carlbuu/RoboCup_Servo_Humanoid/assets/images/robot-full-view.jpg

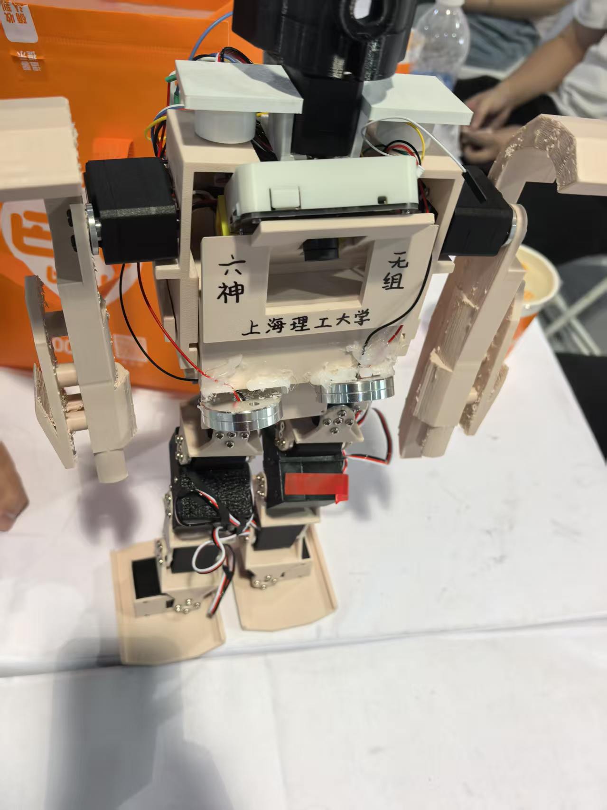
assets/images/robot-full-view.jpg
