carlbuu/RoboCup_Servo_Humanoid/实物图片/robot-front-detail.jpg

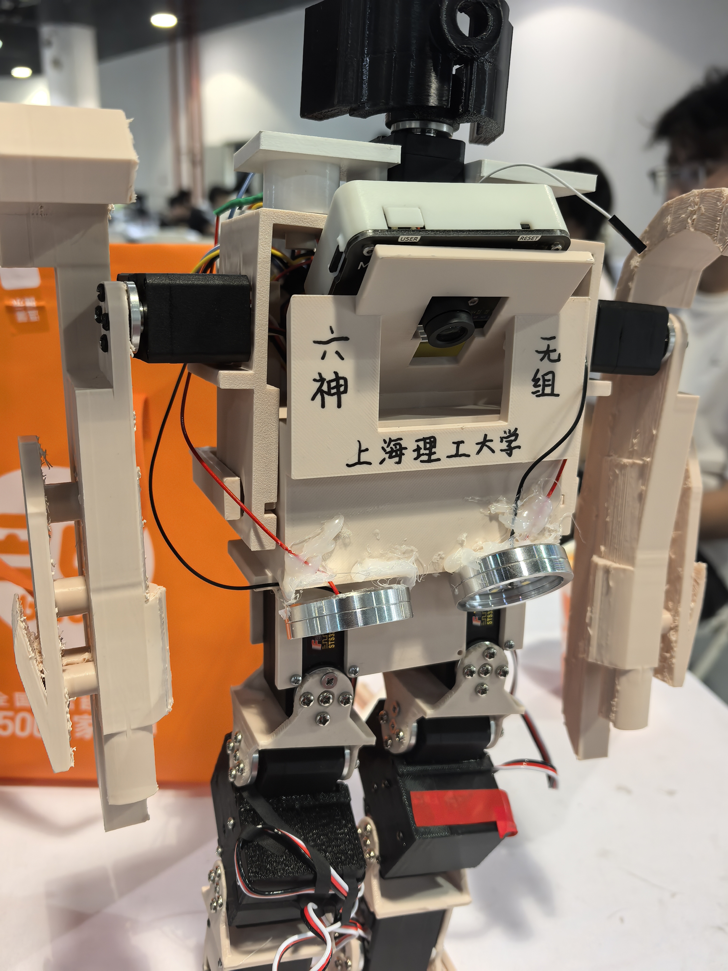
实物图片/robot-front-detail.jpg
