carlbuu/RoboCup_Servo_Humanoid/控制代码.md

---

## 我的电控方案与控制总结

本项目的电控采用“MaixCAM Pro 负责视觉感知、STM32F407 负责动作决策、总线舵机负责关节执行”的分工方式。通过预设动作表和实机步态调试来完成行走、转向及图形动作，并利用视觉结果修正机器人的运动方向。

### 1. 硬件与通信架构

| 模块 | 配置 | 作用 |
|---|---|---|
| 主控制器 | STM32F407，内部 HSI 经 PLL 得到 168 MHz | 解析视觉消息，运行状态机，生成关节目标 |
| 视觉模块 | MaixCAM Pro，`geometry_vision19.py` | 检测赛道边界、判断偏差、识别六种图形 |
| 执行机构 | 13 个 STS3215 总线舵机 | 双腿各 5 个、双臂各 1 个、头部 1 个 |
| 舵机总线 | USART3，经总线转换板连接舵机，1 Mbps | 同步发送各关节的位置、速度和加速度参数 |
| 调试接口 | UART4，PC10 输出，115200 波特率 | 查看动作阶段、视觉接收和通信统计 |

视觉通信使用 USART2，波特率为 115200：相机 TX 接 STM32 的 PD6，相机 RX 接 PA2，各模块共地。相机发送的是前进、转向、平移、停止及图形建议，具体何时执行由 STM32 决定。

整体控制链路为：

```text
图像采集与识别
    → 相机串口发送建议
    → STM32 接收、解析和确认
    → 状态机选择动作及执行时机
    → 动作播放器生成 13 个关节目标
    → 舵机总线同步发送
    → 舵机执行
```

### 2. FreeRTOS 任务分工

控制程序采用 FreeRTOS，将视觉接收、机器人动作调度、舵机发送和调试输出等工作分开处理。视觉接收任务优先处理新数据，机器人任务负责推进动作，舵机任务负责总线发送，低优先级调试任务输出状态。

串口接收采用循环 DMA、空闲中断和消息队列。中断主要负责搬运数据并通知任务，协议解析放在任务中完成，避免在中断里执行较多计算。消息队列保存数据副本，减少接收缓冲区被后续数据覆盖的问题。

我采用这种划分，是为了让接收、决策和执行能够相互配合，减少把串口通信与整段动作混在一起造成的时序问题。FreeRTOS 提供了任务组织方式，通信恢复、请求优先级和动作切换仍需要在程序中明确处理。

### 3. 动作表与关节控制

行走、收脚、左右转向、平移及图形动作都由关键帧动作表描述。每帧保存持续时间和 13 个关节目标角度，角度单位为 0.1°，例如表中的 `180` 对应 18°。

机器人控制任务每 20 ms 推进一次动作，即目标更新频率为 50 Hz。播放器在当前角度与关键帧目标之间做线性插值，让多个关节按统一时间进度运动，而不是直接跳到下一组目标。

```text
当前角度 = 起始角度 +（目标角度 − 起始角度）× 当前帧进度
```

插值后的角度经过舵机 ID 映射，再结合各舵机的中位、方向和软件限位，转换为舵机位置。动作数组下标与 ID 的关系为：

```text
数组下标：0  1  2  3  4  5  6  7  8  9  10 11 12
舵机 ID：5  4  3  2  1  6  7  8  9  10 11 12 13
```

软件发送时，将多个舵机目标装入同一个同步写数据包，通过 USART3 DMA 发送。目标队列长度为 1，新目标可以覆盖尚未取走的旧目标，避免排队执行过期姿态。目标成功进入发送队列，表示软件提交成功，不代表舵机已经实际到位。

当前普通动作速度参数为 1200，快速直行使用 2000；站立和举臂动作使用各自的专用参数。这些数值属于舵机协议参数，不能直接解释为关节的度每秒。

### 4. 视觉巡线与动作调度

视觉程序通过远、近两条扫描带检测赛道中心，远带主要判断前方偏差，近带辅助估计赛道宽度和方向。当前图像分辨率为 640×480，进入纠偏门限为 120 像素，回正门限为 70 像素；使用不同门限，是为了减少前进与纠偏之间的反复切换。

STM32 不会收到一条转向消息就立即打断当前姿态，而是在指定步态窗口内收集新结果，经过两条独立新结果连续同向确认，再决定续走、收脚或纠偏。停止请求独立保存，图形事件单独排队，普通前进建议不能覆盖停止请求。

当前普通采样窗口为动作数组下标 10～11，右转提前采样窗口为下标 9～10。慢速阶段满足姿态匹配、确认和优先级条件时，可以衔接转弯；条件不满足时采用收脚后执行纠偏的路径。快速阶段的转向采用收脚后完整转弯。

协议中的 `TURNL,3`、`TURNR,3` 只提供转向建议，STM32 不按参数 3 换算精确角度或重复次数。实际转角由动作表、脚底接触和机械状态共同决定。

### 5. 慢速与快速步态切换

当前采用两阶段步态：先慢速行走，累计到 30 个软件单脚完成事件后登记切快请求，再完成必要的支撑转换和优先动作，在满足站立条件后切换到快速步态。

30 步是申请切换的阈值，不保证恰好在第 30 步立即换表；为完成支撑转换，实际累计可能达到 31 步。这些计数来自动作帧的软件完成事件，不是脚底传感器确认的落地次数。

快速步态有独立的角度与时长表，配合独立速度参数使用。普通暂停、图形动作和转向不会直接清零累计步数，复位或符合条件的新运行入口可以清零。

### 6. 图形识别与指定动作

视觉侧对图形结果做滑动窗口投票：最近 5 次结果中，同类至少出现 2 票并严格领先其他类别，才触发上报。该投票与 STM32 端巡线的两条同向确认属于不同机制。

| 图形 | 动作 |
|---|---|
| 圆形 | 举左臂 |
| 五角星 | 举右臂 |
| 正方形 | 抬左腿 |
| 菱形 | 抬右腿 |
| 十字形 | 举双臂 |
| 三角形 | 摇头 |

STM32 收到图形事件后，在合适的动作边界结束当前行走、收脚并执行指定动作。当前关闭图形动作前额外完整直行周期，避免无意多走一段距离。视觉侧启用了每类图形在本次程序运行中只触发一次上报尝试的限制，减少重复触发。

### 7. 我的调试认识与当前实现范围

这套方案的重点，是把“视觉建议、动作决策、关节轨迹和总线发送”分开处理。调试时需要分别确认相机是否生成消息、STM32 是否正确接收、状态机是否启动动作，以及机械是否按目标运动，不能仅根据相机打印或编译成功判断整机已经完成动作。

目前行走主要依靠预设步态和视觉方向修正，稳定性很大程度上取决于舵机中位、机械限位、连接件虚位、脚底摩擦和关键帧之间的重心转移。步态调试需要在保护支撑下逐项确认，再逐步增加速度和连续运行距离。
