carlbuu/RoboCup_Servo_Humanoid/比赛资料整理说明.md

# 2026 年 10 月人形机器人比赛资料整理说明

整理日期：2026-10-24。范围仅为原“汇总”文件夹。本文件为整理后的统一阅读入口，参数按本文件夹内的源码核对；它不代表已确认机器人当前烧录的固件或相机正在运行的脚本。

## 1. 资料目录与入口

```text
汇总/
├─ 比赛资料整理说明.md
├─ 01_控制代码/
│  └─ HumanoidRobot_HSI/
│     ├─ MDK-ARM/                 Keil 工程与现有固件
│     ├─ Core/                    初始化、时钟、引脚、任务
│     ├─ User/motion/             动作表、播放器、巡线调度
│     ├─ User/servo/              舵机总线、标定与限位
│     ├─ Drivers/                相机、IMU、串口及芯片驱动
│     ├─ Middlewares/            FreeRTOS 等中间件
│     ├─ Tests/                  测试源码、脚本、桩与必要输入
│     ├─ HumanoidRobot_HSI.ioc    CubeMX 配置
│     └─ 编译.ps1                Keil 批处理编译入口
├─ 02_视觉代码/
│  └─ geometry_vision19.py
├─ 03_机械资料/
│  ├─ 机身/身体.STEP
│  ├─ 手臂/手臂固定1(2).SLDPRT
│  ├─ 头部/头部(1).3mf
│  └─ 腿部/                    5 个 STEP 零件
└─ 04_舵机上位机/
   └─ FD1985-250729/            FD.exe 与配套文件
```

|---|---|
| 打开 STM32 工程 | `01_控制代码/HumanoidRobot_HSI/MDK-ARM/HumanoidRobot_HSI.uvprojx` |
| 查看现有 HEX / AXF | `01_控制代码/HumanoidRobot_HSI/MDK-ARM/HumanoidRobot_HSI/` |
| 运行视觉程序 | `02_视觉代码/geometry_vision19.py`，在 MaixVision / MaixCAM 环境中使用 |
| 改运行模式和步态策略 | `01_控制代码/HumanoidRobot_HSI/User/motion/robot_walk_config.h` |
| 查看动作关键帧 | `01_控制代码/HumanoidRobot_HSI/User/motion/motion_groups.c` |
| 查看关节与舵机 ID 映射 | `01_控制代码/HumanoidRobot_HSI/User/motion/robot_joints.h` |
| 查看中位、方向、限位 | `01_控制代码/HumanoidRobot_HSI/User/servo/servo_manager.c` |
| 打开舵机上位机 | `04_舵机上位机/FD1985-250729/FD.exe` |

## 2. STM32 工程现状

Keil 工程设备字段为 STM32F407VETx，使用 ARM Compiler 5（工程配置 `uAC6=0`）。系统采用内部 HSI，经 PLL 得到 168 MHz；HAL 时基为 TIM6，任务使用 FreeRTOS。具体配置以 `Core/Src/main.c`、`Core/Src/usart.c` 和 `.ioc` 为准。

| 配置项 | 当前值 | 含义 |
|---|---|---|
| `ROBOT_RUN_MODE` | `ROBOT_MODE_FULL_RUN`，3 | 完整巡线与图形动作流程 |
| `ROBOT_DEBUG_MOTION` | `motion_walk_forward` | 只在模式 1 中生效 |
| `ROBOT_CONTROL_PERIOD_MS` | 20 ms | 控制周期 |
| `SERVO_TASK_PERIOD_MS` | 20 ms | 舵机任务周期 |
| `SERVO_ACTIVE_COUNT` / `SERVO_COUNT` | 13 / 13 | 使用 ID1～13 |
| `CAMERA_PROTOCOL_BINARY` | 0 | ASCII 串口协议 |
| `ROBOT_STM_AUTOSTART` | 0 | 等待视觉授权起步 |
| `ROBOT_STM_WALK_BATCH_STEPS` | 4 | 正常批次步数配置 |
| `ROBOT_WALK_LATE_VISION` | 1 | 行走周期后段采样 |
| `ROBOT_WALK_DECIDE_EACH_CYCLE` | 1 | 每周期独立决策 |
| `ROBOT_WALK_VOTE_WINDOW` / `NEED` | 2 / 2 | 两条独立新结果连续同向确认 |
| `ROBOT_WALK_TURN_HANDOFF_ENABLE` | 1 | 启用满足条件时的慢速行走转弯衔接 |
| `ROBOT_SLOW_STAGE_STEPS` | 30 | 到阈值后申请安全切快 |
| `ROBOT_SHAPE_STEP_BEFORE_ACTION` | 0 | 图形动作前不额外增加完整直行周期 |
| `ROBOT_WALK_SETTLE_MS` / `TURN_SETTLE_MS` | 0 / 0 | 组外额外等待为零，动作组内回站时间仍存在 |
| `ROBOT_RX_DIAGNOSTICS_ENABLE` | 0 | 日常关闭详细接收诊断 |

四种模式：1 为动作调试；2 为图形调试；3 为完整流程；4 为巡线调试并忽略图形。模式入口集中在 `robot_walk_config.h`。

### 行走与纠偏

普通采样窗口为数组下标 10～11；右转提前采样窗口为下标 9～10。下标从 0 开始。慢速满足确认、优先级与姿态条件时可衔接转向；未及时满足时仍有原收脚路径。左转接近段含额外一次右脚迈出。停止和图形事件的调度仍由 `robot_walk_vision.c` 处理。

TURN 建议只提供方向，参数不换算成重复转弯次数。一次建议经过 STM32 端确认和调度后执行有限动作，结束后再判断新建议。相机打印发送消息、STM32 接收消息和机器人启动动作是三个不同环节，应分别查看日志。

累计到 30 个软件单脚完成事件后登记切快请求，在安全站立边界切换；可能因支撑转换累计到 31 步。它不是足底落地反馈。快速直行速度参数为 2000，普通动作速度参数为 1200；播放器另有站立和手臂专用分支。快速阶段的转向走收脚后完整转弯路径。复位或成功执行显式新运行入口可清零计步，普通暂停、图形与转弯不会直接清零。

### 编译入口

可在 Keil 打开上述 `.uvprojx`，也可进入 `01_控制代码/HumanoidRobot_HSI/` 后执行：

```powershell
.\编译.ps1
# Keil 安装位置不同时：
.\编译.ps1 -KeilExe '实际安装目录\UV4.exe'
```

脚本通过 `-KeilExe` 参数、`KEIL_UV4` 环境变量或 PATH 中的 `UV4.exe` 定位 Keil，通过临时目录编译后回写生成物；脚本不执行硬件下载。建议使用 PowerShell 7。本次整理没有重新构建。需要下载时先重新编译并核对目标工程与生成物。

## 3. 接线与通信

| 功能 | STM32 引脚 | 接线与速率 |
|---|---|---|
| 调试日志 | PC10，UART4 TX | 接 USB-TTL RXD，115200，8N1；UART4 仅 TX |
| IMU | PA9 TX / PA10 RX，USART1 | 115200，8N1 |
| 相机 | PA2 TX / PD6 RX，USART2 | PA2 接相机 RX、PD6 接相机 TX，115200，8N1 |
| 舵机总线 | PB10 TX / PB11 RX，USART3 | 1 Mbps，经实际使用的总线转换板连接 |
| 固定 GPIO | PA1 | 初始化后输出高电平 |

各模块共地。PA3 在这份 HSI 工程中未用作相机 RX。PC10 是此工程的日志口。

常见日志：`[BOOT] HumanoidRobot_HSI PA1=HIGH DEBUG=PC10`、`[CLOCK] HSI->PLL ...`、`[TURN]`、`[HANDOFF]`、`[GAIT]`、`[STEP]`。结合动作启动与完成日志判断执行情况。

默认 ASCII 示例，每条以换行结束：

```text
CMD,FWD,2
CMD,TURNL,3
CMD,TURNR,3
CMD,HOLD,0
CMD,BLOCKED,0
SHAPE,CIRCLE,1
```

代码还支持左右平移建议。改二进制协议时需同步 STM32 的 `CAMERA_PROTOCOL_BINARY` 与视觉的 `SERIAL_MODE`。视觉脚本中的图形帧为 `AA 55 ID (ID xor A5) 0A`；命令帧为 `AA 57 CMD ARG (CMD xor ARG) 0A`。

| 图形 ID | 图形 | STM32 动作映射 |
|---:|---|---|
| 1 | 圆形 | 左臂 |
| 2 | 五角星 | 右臂 |
| 3 | 正方形 | 左腿 |
| 4 | 菱形 | 右腿 |
| 5 | 十字形 | 双臂 |
| 6 | 三角形 | 摇头 |

动作映射依据 `motion_groups.c` 中的 `MotionGroups_FromQr()`；脚本类别名与 ID 依据 `geometry_vision19.py`。

## 4. 视觉程序

本资料包的视觉入口为 `02_视觉代码/geometry_vision19.py`。该文件用于 MaixCAM / MaixPy v4，可在 MaixVision 中运行。文件名和头部版本注释不能证明设备当前正在运行这一版。

| 参数 | 当前值 | 说明 |
|---|---|---|
| `UART_PORT` / `UART_BAUD` | `/dev/ttyS0` / 115200 | 当前配置会尝试打开 UART；文件内“仅调视觉”注释不等于禁止发送 |
| `SERIAL_MODE` | `ascii` | 对应 STM32 默认协议 |
| `CORR_ON` | `True` | 允许纠偏建议 |
| `CORR_E_TOL` / `CORR_E_OK` | 120 / 70 | 偏差与回正门限，按脚本分辨率缩放逻辑使用 |
| `CORR_BAND` / `CORR_BAND_N` | 0.62 / 0.90 | 远、近扫描带比例 |
| `CORR_SEND_INTERVAL_MS` | 100 ms | 建议发送间隔限制，不代表实际 10 fps |
| `CORR_LOST_N` | 5 | 连续丢线阈值 |
| `EDGE_NEED_PRIOR` | `True` | 单边外推需要已有可靠双边先验 |
| `VOTE_WIN` / `VOTE_NEED` / `VOTE_CONF` | 5 / 2 / 0.45 | 图形投票，与 STM32 巡线 2/2 确认分属两套机制 |
| `DEBUG` | `False` | 控制特征等调试输出 |

程序会对卡片候选四边形做边界检查，并用卡片区域辅助排除巡线干扰。启动可见 `[VISION_CFG] quad_guard=1 ...`。只有一条边且尚无宽度/中心先验时可能报丢线；应核对真实视野和日志，不能直接把 `EDGE_NEED_PRIOR` 关闭当作修复。

## 5. 舵机与机械资料

活动工程使用 13 个舵机。关节到 ID 的映射按 `robot_joints.h` 中的 `RobotJoint_ServoId()`；中位、方向与限位按 `servo_manager.c` 中的 `s_servo`。

| 舵机 ID | 当前关节映射 | 方向 | 中位 | 软件最小 | 软件最大 |
|---:|---|---:|---:|---:|---:|
| 1 | 左踝侧摆 | +1 | 2048 | 1799 | 2609 |
| 2 | 左踝前后 | -1 | 2048 | 1589 | 2520 |
| 3 | 左膝前后 | -1 | 2048 | 1705 | 2954 |
| 4 | 左髋前后 | +1 | 2048 | 1628 | 2873 |
| 5 | 左髋侧摆 | +1 | 2048 | 1720 | 2490 |
| 6 | 右髋侧摆 | -1 | 2048 | 1476 | 2464 |
| 7 | 右髋前后 | +1 | 2048 | 1633 | 2873 |
| 8 | 右膝前后 | -1 | 2048 | 1660 | 2607 |
| 9 | 右踝前后 | +1 | 2048 | 1512 | 2581 |
| 10 | 右踝侧摆 | -1 | 2048 | 1352 | 2266 |
| 11 | 左臂前举 | -1 | 2048 | 0 | 4095 |
| 12 | 右臂前举 | +1 | 2048 | 0 | 4095 |
| 13 | 头部左右 | +1 | 2048 | 0 | 4096 |

ID13 的表内最大值确实写为 4096，而通用 `SERVO_POSITION_MAX` 为 4095；此处如实记录原代码，本次未修改该差异。动作数组前五个关节按 ID5→ID1 映射，不能把数组下标直接当作舵机 ID。

换算为：原始位置约等于 `中位 + 角度 / 0.087 × direction`，再按代码限位。以上是软件配置，不等同于机械已重新标定。换装舵机、舵盘或连杆后，应在支撑保护下逐关节核对 ID、中位、方向与止挡，再验证整组动作。

机械原件保留原文件名与内容：

| 分类 | 文件 | 使用方式 |
|---|---|---|
| 机身 | `机身/身体.STEP` | STEP 模型，可导入 CAD |
| 手臂 | `手臂/手臂固定1(2).SLDPRT` | SolidWorks 原生零件 |
| 头部 | `头部/头部(1).3mf` | 3MF 文件，用兼容的建模或切片软件查看 |
| 腿部 | `腿部/大腿上连杆.STEP`、`脚.STEP`、`脚踝连杆.STEP`、`零件2.STEP`、`膝盖小腿连杆.STEP` | 共 5 个 STEP 零件 |

以上机械文件仅做参考，可能不全。

舵机工具入口为 `04_舵机上位机/FD1985-250729/FD.exe`。配套 `ft_setup_bat` 整体保留，其中 `.log` 文件可能被配套批处理使用，没有按普通运行日志删除；本次没有启动软件或向舵机写参数。

## 发布与测试入口

主机测试脚本默认从 PATH 查找 GCC，也可通过 `-Compiler` 指定完整路径；仅定位当前工程，源码保护使用内存快照。当前主要入口为 `run_dual_gait_tests.ps1`、`run_walk_turn_handoff_tests.ps1`、`run_walk_late_vision_tests.ps1` 与 `test_walk_late_camera.py`。需要参考源码或固定参考配置的其他测试，使用条件见 `Tests/README.md`。

编译中间文件已清理，`.gitignore` 会排除后续生成物和本机厂商上位机目录。`.sct` 链接脚本、启动源码、工程文件和第三方许可证保留。现有 HEX 留在本机，后续可自行通过 Releases 发布重新构建并核对过的固件。

厂商上位机的再分发权限尚未确认，因此仅保留在本机并排除 Git 提交；通过网页上传时同样应排除 `04_舵机上位机/FD1985-250729/`。原创内容尚未指定开源许可证，第三方许可入口见根目录 `NOTICE`。
