carlbuu/RoboCup_Servo_Humanoid/04_舵机上位机/使用说明.md

# 舵机上位机

本项目使用飞特 STS3215 总线舵机。上位机用于查看和设置舵机 ID、中位及通信参数。

本机已有的工具位于 `FD1985-250729/FD.exe`。该目录的程序及配套文件未确认再分发授权，已由根目录 `.gitignore` 排除。克隆仓库后，请通过飞特官方渠道自行获取兼容工具。

`ft_setup_bat` 中的 `.log` 文件是配套批处理读取的输入，不能只凭扩展名当作普通日志删除。使用本机工具时应保持配套目录完整。

连接和标定方法见根目录的《比赛资料整理说明.md》。本仓库不自动启动上位机，也不自动写入舵机参数。
