carlbuu/RoboCup_Servo_Humanoid/03_机械资料/头部/头部(1).3mf

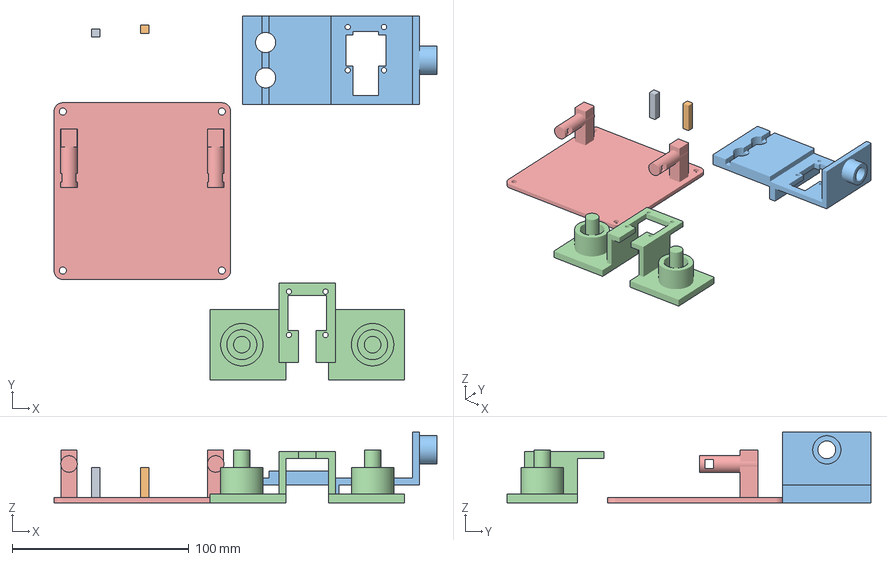
[picture p3: CAD file, 2026-10-24]
03_机械资料/头部/头部(1).3mf
216.8 x 206.0 x 40.0 mm
板子固定 x 2
手臂支撑
头部
固定板
