carlbuu/RoboCup_Servo_Humanoid/03_机械资料/手臂/手臂固定1(2).SLDPRT

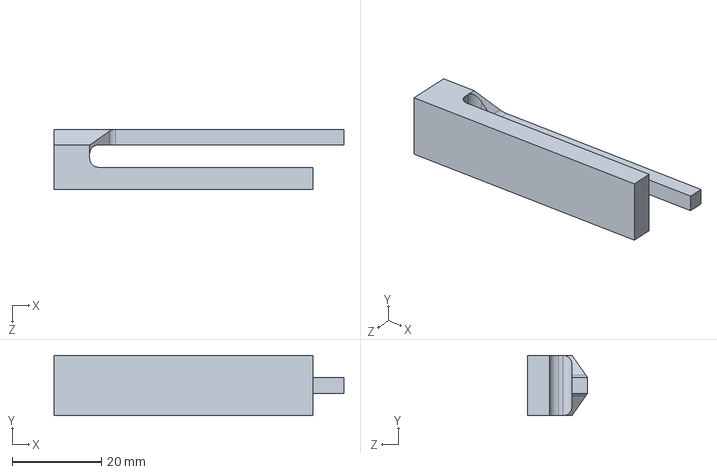
[picture p4: CAD file, 2026-10-24]
03_机械资料/手臂/手臂固定1(2).SLDPRT
65.0 x 13.5 x 13.5 mm
