carlbuu/RoboCup_Servo_Humanoid/03_机械资料/机身/身体.STEP

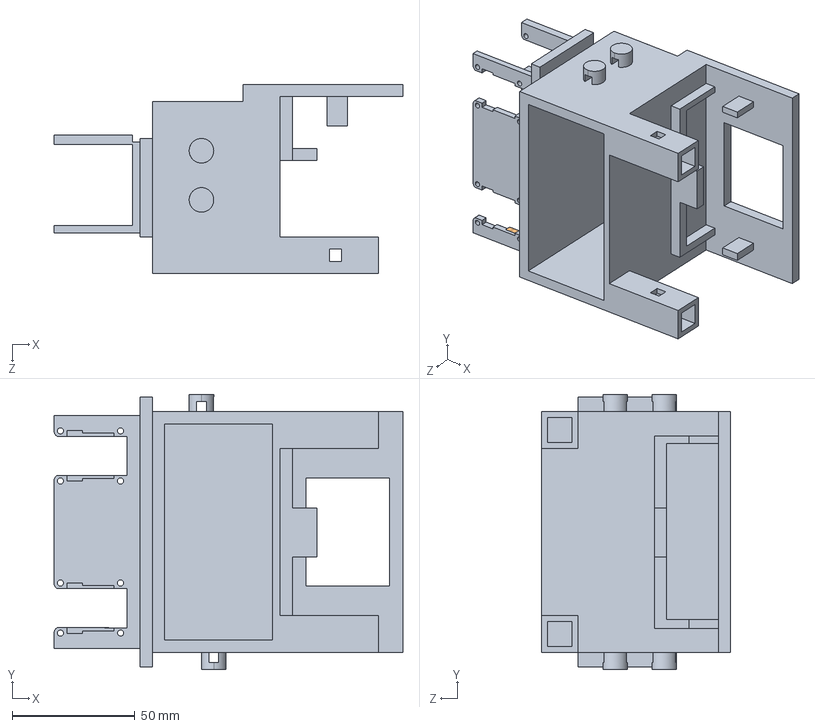
[picture p5: CAD file, 2026-10-24]
03_机械资料/机身/身体.STEP
142.0 x 112.0 x 77.0 mm
