carlbuu/RoboCup_Servo_Humanoid/03_机械资料/腿部/零件2.STEP

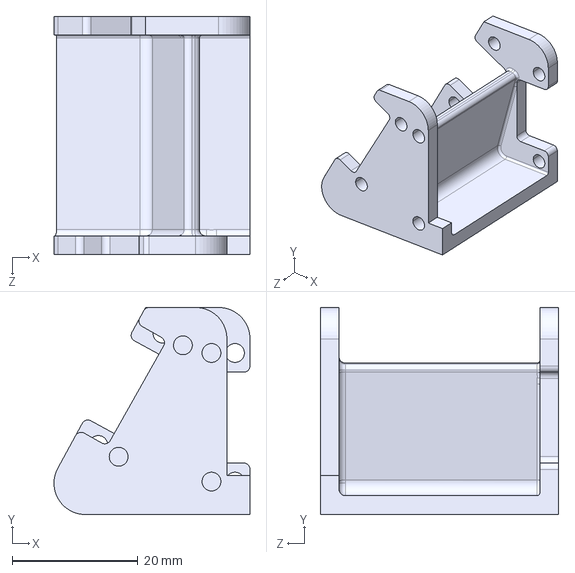
[picture p7: CAD file, 2026-10-24]
03_机械资料/腿部/零件2.STEP
31.2 x 33.0 x 38.0 mm
