carlbuu/RoboCup_Servo_Humanoid/03_机械资料/腿部/脚踝连杆.STEP

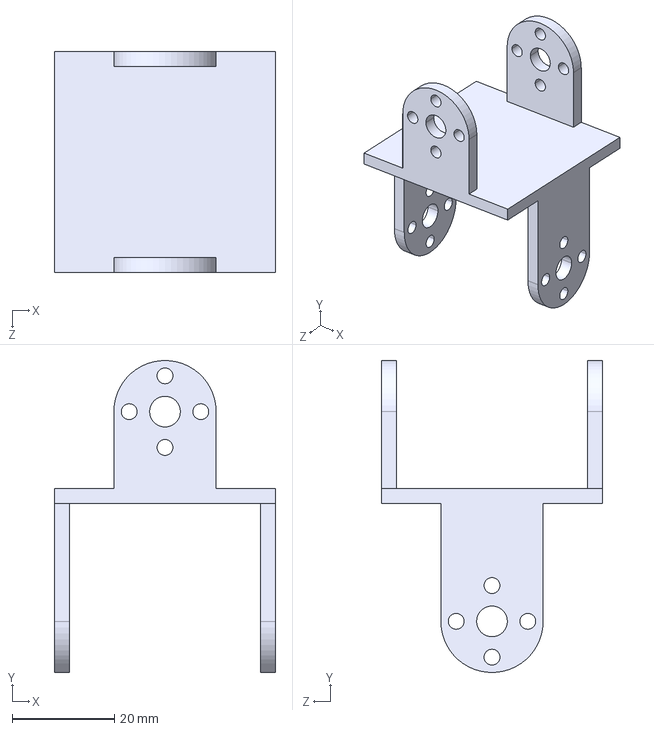
[picture p8: CAD file, 2026-10-24]
03_机械资料/腿部/脚踝连杆.STEP
43.3 x 61.0 x 43.3 mm
