carlbuu/RoboCup_Servo_Humanoid/03_机械资料/腿部/膝盖小腿连杆.STEP

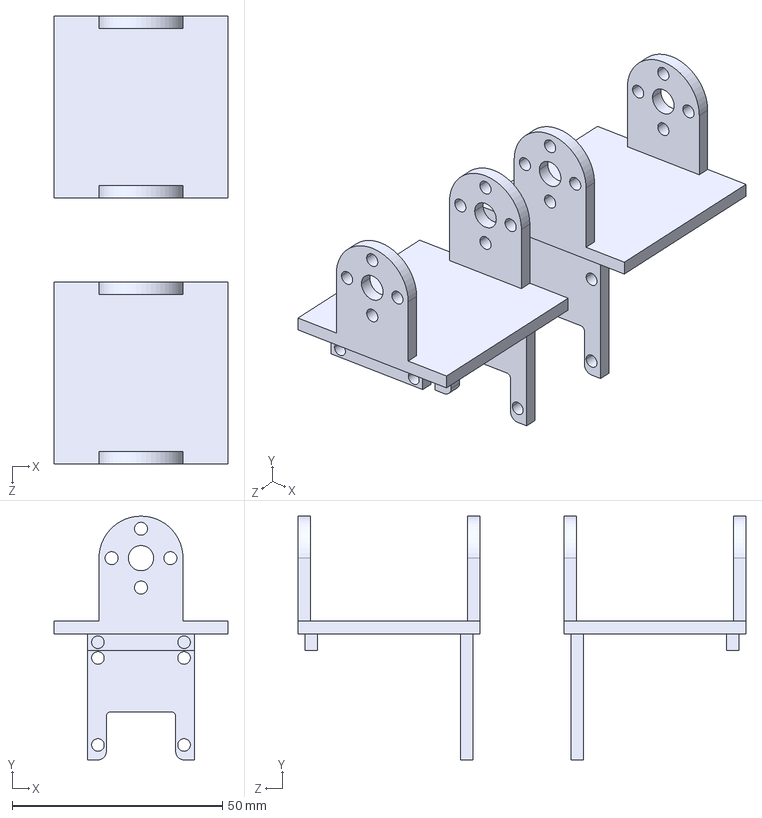
[picture p9: CAD file, 2026-10-24]
03_机械资料/腿部/膝盖小腿连杆.STEP
41.3 x 58.0 x 106.6 mm
