carlbuu/RoboCup_Servo_Humanoid/03_机械资料/腿部/脚.STEP

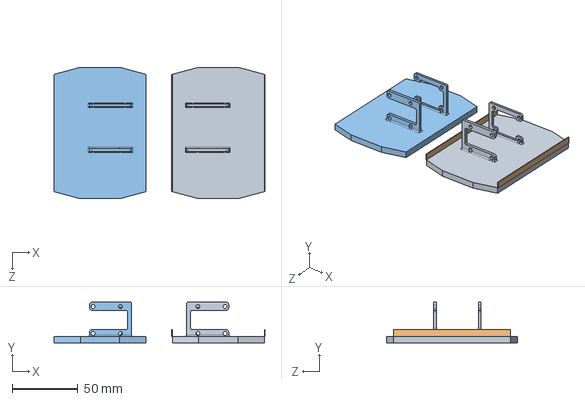
[picture p10: CAD file, 2026-10-24]
03_机械资料/腿部/脚.STEP
160.6 x 31.0 x 100.0 mm
