carlbuu/RoboCup_Servo_Humanoid/01_控制代码/HumanoidRobot_HSI/User/motion/motion_groups.c

#include "motion_groups.h"

#define ARRAY_COUNT(array) ((uint8_t)(sizeof(array) / sizeof((array)[0])))//计算数组元素数量

/*
 * 每帧角度的顺序固定为：
 * 右髋侧、右髋前、右膝、右踝前、右踝侧，
 * 左髋侧、左髋前、左膝、左踝前、左踝侧，
 * 左肩、右肩、头。右腿对应 ID5~ID1，其余对应 ID6~ID13。
 *
 * 表内数值单位为 0.1 度。例如 180 表示 18.0 度；0度对应各舵机标定零位。
 * 站立姿态保留明显屈膝，满足比赛“行走时膝关节明显弯曲”的要求。
 */

static const MotionFrame_t s_stand[] =
{
    { 2000, { 0, 0, 0, 0, 0,   0, 0, 0, 0, 0,  0, 0, 0 } }//站立姿态全为各舵机标定零位
};

static const MotionFrame_t s_walk_tostand[] =
{
    
	//{ 500, {   -20,    -250,  100,   150,220,     0,   320,   -250,   20,-90,    0, 0, 0 } },
	{ 400, {   40,   290,   -200,   0, 0,     -30,    0,   0,   20, -110,  140, -140, 0 } },//右腿悬空
	 { 900, { 0, 0, 0, 0, 0, 0, 0, 0, 0, 0, 0, 0, 0 } }
};

/* 保守的准静态双足步态；现场标定时优先调整侧移量和踝关节补偿。 */
/* 双臂方向以实机确认为准：右腿前迈时左臂负摆、右臂正摆。
 * 幅度约正负18度，随迈腿逐步摆开，跨立附近达峰，换脚时经过中位。
 * 第12帧保留14度摆幅；收脚首帧沿用该目标，再随站立缓慢回零。
 * 腿部角度、头部角度和各帧时长保持不变。 */
static const MotionFrame_t s_walkForward[] =
{
	{ 100, {   0,   0,   0,   0,   0,      	0,    0,   0,   0,   0,  0, 0, 0 } },//1
	{ 400, {   0,   0,   0,   0, 70,      	-20,    0,   0,   0, 0,  0, 0, 0 } },//2
	{ 380, {   40,   0,   0,   0, 70,      	-30,    0,   0,   20, -110,  -20, 20, 0 } },//3
	{ 500, {   40,   290,   -200,   0, 0,   -30,    0,   0,   20, -110,  -80, 80, 0 } },//4右腿悬空  
	{ 360, {   0,   400,   -200,   -35,45,  -20,    0,     0,   60, -80,  -130, 130, 0 } },//5
	{ 460, {   0,   400,   -300,   -35,0,   -20,    -250,  100,   150, 0,  -170, 170, 0 } },//6
	{ 510, {   0,   320,   -300,   0,0,     -20,    -250,  100,   150,0,  -180, 180, 0 } },//7右标准跨立姿态	
	{ 430, {   0,   320,   -300,   0,-110,  -10,    -250,  100,   150,200,  -120, 120, 0 } },//8
	{ 450, {   0,   0,  0,   0,		-110,   0,    -100,  100,   0,0,  -20, 20, 0 } },//9左腿悬空
	{ 580, {   -20,  0,   0,   60, -80,      0,     400,   -200,  -35,45,  100, -100, 0 } },//10
	{ 600, { -17, -215, 104, 182, 3,   		0, 		400, -300, -37, -2,  180, -180, 0 } },//11左标准跨立姿态
	{ 500, {  -17, -215, 104, 182,220,     	0,   320,   -250,   20,-90,  140, -140, 0 } },//12
	{ 720, {   40,   290,   -200,   0, 0,     -30,    0,   0,   20, -110,  -80, 80, 0 } },//13右腿悬空/
	

	
};

/* Reference fast gait: retain every angle and duration; slow table stays intact. */
static const MotionFrame_t s_walkForwardFast[] =
{
	{ 100, {   0,   0,   0,   0,   0,      	0,    0,   0,   0,   0,  0, 0, 0 } },//1
	{ 400, {   0,   0,   0,   0, 70,      	-20,    0,   0,   0, 0,  0, 0, 0 } },//2
	{ 300, {   40,   0,   0,   0, 70,      	-30,    0,   0,   20, -110,  -20, 20, 0 } },//3
	{ 300, {   40,   300,   -200,   0, 0,   -30,    20,   0,   20, -110,  -80, 80, 0 } },//4右腿悬空  
	{ 350, {   0,   400,   -100,   -35,45,  -20,    -60,     0,   60, -80,  -130, 130, 0 } },//5 右腿前摆：参照第10帧左腿前摆，实机待验证
	{ 460, {   0,   400,   -300,   -35,0,   -20,    -250,  100,   150, 0,  -170, 170, 0 } },//6
	{ 500, {   0,   400,   -300,   0,0,     -20,    -250,  100,   150,0,  -180, 180, 0 } },//7右标准跨立姿态	
	{ 300, {   0,   400,   -300,   0,-110,  -10,    -250,  100,   150,200,  -120, 120, 0 } },//8
	{ 300, {   0,   0,  0,   0,		-110,   20,    -100,  100,   0,0,  -20, 20, 0 } },//9左腿悬空
	{ 300, {   -20,  -30,   0,   60, -80,      20,     400,   0,  -35,45,  100, -100, 0 } },//10
	{ 600, { -17, -265, 104, 182, 3,   		20, 		400, -300, -35, 10,  180, -180, 0 } },//11左标准跨立姿态
	{ 500, {  -17, -265, 104, 182,220,     	20,   320,   -250,   20,-90,  140, -140, 0 } },//12
	{ 600, {   40,   300,   -200,   0, 0,     -30,    0,   0,   20, -110,  -80, 80, 0 } },//13右腿悬空/
	
	
};

/* 左转 */
static const MotionFrame_t s_turnLeft[] =
{
	{ 400, {   0,   0,   0,   0, 70,      		-20,    0,   0,   0, 0,   0, 0, 0 } },
	{ 360, {   40,   0,   0,   0, 70,      		-30,    0,   0,   20, -110,   0, 0, 0 } },
	{ 440, {   40,   290,   -200,   0, 0,     -30,    0,   0,   20, -110,   0, 0, 0 } },//右腿悬空  
	{ 440, {   0,   400,   -200,   -35,45,     -20,    0,     0,   60, -80,  0, 0, 0 } },
	{ 440, {   0,   400,   -300,   -35,0,   -20,    -250,  100,   150, 0,   0, 0, 0 } },
	{ 440, {   0,   320,   -300,   0,0,     -20,    -250,  100,   150,0,   0, 0, 0 } },//右标准跨立姿态	
	{ 600, {0, 0, 0, 0, 0,     	   0, 0, 0, 0, 0,    0,0, 0 } },
	
};

static const MotionFrame_t s_turnRight[] =
{
	{ 400, {   -20,   0,   0,   0, 0,      		0,    0,   0,   0, 70,   0, 0, 0 } },
	{ 360, {   -30,   0,   0,   0, -110,      		0,    0,   0,   0, 70,   0, 0, 0 } },
	{ 520, {   -30,   0,  0,   0,	-110,   -10,    -100,  100,   0,0,   0, 0, 0 } },//左腿悬空
	{ 600, {   -20,  0,   0,   60, -80,      	0,     400,   -200,  -35,45,   0, 0, 0 } }, 
	{ 440, { -17, -215, 104, 182, 3,   			0, 		400, -300, -37, -2,   0, 0, 0 } },//左标准跨立姿态
	{ 600, {0, 0, 0, 0, 0,     	   0, 0, 0, 0, 0,    0,0, 0 } },
};
/* 弯腰识别图片 */
static const MotionFrame_t s_bandover[] =
{
	{ 1500, {0, 600, -400, 0, 0,    0, 600, -400, 0, 0,    0,0, 0 } },
};
/* 圆形 1：左手举起并保持 3.2 秒。 */
static const MotionFrame_t s_qrRightArm[] =
{
    
    { 800, { 0, 0, 0, 0, 0, 0, 0, 0, 0, 0, 1800, 0, 0 } },
	{ 3200, { 0, 0, 0, 0, 0, 0, 0, 0, 0, 0, 1800, 0, 0 } },
    { 800, { 0, 0, 0, 0, 0, 0, 0, 0, 0, 0, 0, 0, 0 } }
};

/* 五角星 2：右手举起并保持 3.2 秒。 */
static const MotionFrame_t s_qrLeftArm[] =
{
    
    { 800, { 0, 0, 0, 0, 0, 0, 0, 0, 0, 0, 0, 1800, 0 } },
	{ 3200, { 0, 0, 0, 0, 0, 0, 0, 0, 0, 0, 0, 1800, 0 } },
    { 800, { 0, 0, 0, 0, 0, 0, 0, 0, 0, 0, 0, 0, 0 } }
};

/* 正方形 3：重心移向右脚，抬右腿。 */
static const MotionFrame_t s_qrRightLeg[] =
{
	{ 300, {0, 0, 0, 0, 100,    0, 0, 0, 0, -70,    0,0, 0 } },
	{ 300, {-100, 0, 0, 0, 100,    120, 0, 0, 0, -70,    0,0, 0 } },
	{ 300, {-100, 150, 0, 0, 100,    120, 0, 0, 0, -70,    0,0, 0 } },//抬右腿
	{ 3200, {-100, 150, 0, 0, 100,    120, 0, 0, 0, -70,    0,0, 0 } },//抬右腿3.2s
	{ 300, {-100, 0, 0, 0, 100,    120, 0, 0, 0, -70,    0,0, 0 } },
	{ 300, {0, 0, 0, 0, 100,    0, 0, 0, 0, -70,    0,0, 0 } },
	{ 1000, { 0, 0, 0, 0, 0, 0, 0, 0, 0, 0, 0, 0, 0 } },
};

/* 棱形 4：重心移向左脚，抬左腿保持 3.2 秒。 */
static const MotionFrame_t s_qrLeftLeg[] =
{

	{ 300, {0, 0, 0, 0, -70,   0, 0, 0, 0, 100,     0,0, 0 } },
	{ 300, {120, 0, 0, 0, -70,  -140, 0, 0, 0, 100,   0,0, 0 } },
	{ 300, {120, -50, 0, 0, -70,    -140, 100, 0, -100, 100,    0,0, 0 } },
	{ 900, { 130, -50, 0, 0, -70,    -150, 100, 0, -200, 0,     0,0, 0 } },//抬左腿
	{ 3200, { 130, -50, 0, 0, -70,    -150, 100, 0, -200, 0,     0,0, 0 } },//保持左腿3.2s
	{ 300, {120, -50, 0, 0, -70,    -140, 100, 0, -100, 100,    0,0, 0 } },
	{ 300, {120, 0, 0, 0, -70,  -140, 0, 0, 0, 100,   0,0, 0 } },
	{ 300, {0, 0, 0, 0, -70,   0, 0, 0, 0, 100,     0,0, 0 } },
	{ 700,{ 0, 0, 0, 0, 0, 0, 0, 0, 0, 0, 0, 0, 0 } },
};

/* 十字 5：双手举起并保持 3.2 秒。 */
static const MotionFrame_t s_qrBothArms[] =
{

    { 1200, { 0, 0, 0, 0, 0, 0, 0, 0, 0, 0, 1800, 1800, 0 } },
	{ 3500, { 0, 0, 0, 0, 0, 0, 0, 0, 0, 0, 1800, 1800, 0 } },
    { 600, { 0, 0, 0, 0, 0, 0, 0, 0, 0, 0, 0, 0, 0 } }
};

/* 三角形 6：连续左右摇头超过 3 秒，最后回到正前方。 */
static const MotionFrame_t s_qrHeadShake[] =
{
    { 1000, { 0, 0, 0, 0, 0, 0, 0, 0, 0, 0, 0,0, -900 } },

	{ 1000, { 0, 0, 0, 0, 0, 0, 0, 0, 0, 0, 0,0,900 } },
	{ 1000, { 0, 0, 0, 0, 0, 0, 0, 0, 0, 0, 0,0, -900 } },

	{ 1000, { 0, 0, 0, 0, 0, 0, 0, 0, 0, 0, 0,0,900 } },
	{ 400, { 0, 0, 0, 0, 0, 0, 0, 0, 0, 0, 0,0, 0 } },
	
};

/*
 * 20 mm 木条的慢速跨越动作。先跨左腿，再转移重心并跨右腿；
 * 动作中避免脚尖前扫，减少碰动木条导致越障 60 分失效的风险。
 */
static const MotionFrame_t s_stepOver[] =
{
//    { 900, {   0,   0,   0,   0,   0,      0,    0,   0,   0,   0,  0, 0, 0 } },
//	{ 600, {   0,   0,   0,   0, 80,      0,    0,   0,   0, -90,   0, 0, 0 } },
//	{ 400, {   40,   0,   0,   0, 80,      -20,    0,   0,   0, -90,   0, 0, 0 } },
//	{ 400, {   40,   250,   -200,   0, 0,      -30,    0,   0,   0, -90,   0, 0, 0 } },
//	{ 400, {   40,   250,   -200,   -20, 0,      -30,    0,   0,   0, -90,   0, 0, 0 } },//右腿悬空
	{ 400, {   0,   500,   -200,   -120, 0,      60,    60,   -0,   180, -90,   0, 0, 0 } },
};
/*
 * 左侧平移。
 */
static const MotionFrame_t s_left_translation[] =
{
	{ 400, {   0,   0,  0,  0, 0,      0,   0,   0,  0, 0,   0, 0, 0 } },
	{ 400, {   100,   0,  0,  0, 0,      0,   0,   0,  0, 0,   0, 0, 0 } },
	{ 400, {   0,   0,  0,  0, 0,      0,   0,   0,  0, 0,   0, 0, 0 } },
};

/*
 * 右侧平移。
 */
static const MotionFrame_t s_right_translation[] =
{
	{ 600, {   0,   0,  0,  0, 0,      0,   0,   0,  0, 0,   0, 0, 0 } },
	{ 400, {   0,   0,  0,  0, 0,      150,   0,   0,  0, 0,   0, 0, 0 } },
	{ 400, {   0,   0,  0,  0, 0,      0,   0,   0,  0, 0,   0, 0, 0 } },
};

static const MotionGroup_t s_groups[motion_group_count] =
{
    { "stand",				s_stand,       			ARRAY_COUNT(s_stand),       		1 },
    { "walk",        		s_walkForward,			ARRAY_COUNT(s_walkForward),			1 },
    { "turn_left",   		s_turnLeft,    			ARRAY_COUNT(s_turnLeft),    		1 },
    { "turn_right",  		s_turnRight,   			ARRAY_COUNT(s_turnRight),  			1 },
    { "left_arm",    		s_qrLeftArm,   			ARRAY_COUNT(s_qrLeftArm),  			0 },
    { "right_arm",   		s_qrRightArm, 			ARRAY_COUNT(s_qrRightArm),  		0 },
    { "left_leg",    		s_qrLeftLeg,   			ARRAY_COUNT(s_qrLeftLeg),   		0 },
    { "right_leg",   		s_qrRightLeg,  			ARRAY_COUNT(s_qrRightLeg), 			0 },
    { "both_arms",   		s_qrBothArms,  			ARRAY_COUNT(s_qrBothArms), 			0 },
    { "head_shake",  		s_qrHeadShake, 			ARRAY_COUNT(s_qrHeadShake), 		0 },
    { "step_over",   		s_stepOver,    			ARRAY_COUNT(s_stepOver),   	 		0 },
	{ "band_over",   		s_bandover, 			ARRAY_COUNT(s_bandover),    		0 },
	{ "walk_tostand",    	s_walk_tostand,			ARRAY_COUNT(s_walk_tostand),		0 },
	{ "left_translation",	s_left_translation,		ARRAY_COUNT(s_left_translation),	1 },
	{ "right_translation",	s_right_translation,	ARRAY_COUNT(s_right_translation),	1 },
	
    { "walk_fast", s_walkForwardFast, ARRAY_COUNT(s_walkForwardFast), 1 },
};

const MotionGroup_t *MotionGroups_Get(MotionId_t id)
{
    if ((uint8_t)id >= (uint8_t)motion_group_count)
    {
        return &s_groups[motion_stand];
    }

    return &s_groups[id];
}

MotionId_t MotionGroups_FromQr(uint8_t qrNumber)
{
    static const MotionId_t qrActions[6] =
    {
        motion_qr_left_arm,
        motion_qr_right_arm,
        motion_qr_left_leg,
        motion_qr_right_leg,
        motion_qr_both_arms,
        motion_qr_head_shake
    };

    if ((qrNumber < 1U) || (qrNumber > 6U))
    {
        return motion_stand;
    }

    return qrActions[qrNumber - 1U];
}
