carlbuu/RoboCup_Servo_Humanoid/01_控制代码/HumanoidRobot_HSI/Tests/test_walk_recovery_original_limit.c

/* Run the original recovery regression without changing its 5-degree limit. */
#define main original_three_modes_main
#include "test_three_modes.c"
#undef main
int main(void) { TestWalkRecoveryContinuity(); return 0; }
