carlbuu/RoboCup_Servo_Humanoid/(notices)

Notices in the files:
01_控制代码/HumanoidRobot_HSI/Core/Src/main.c:
Copyright (c) 2026 STMicroelectronics.
All rights reserved.
This software is licensed under terms that can be found in the LICENSE file
